immortal-sniper1/Bird_Detector/Bird_detector_V1/Pictures/Audio_Power.png

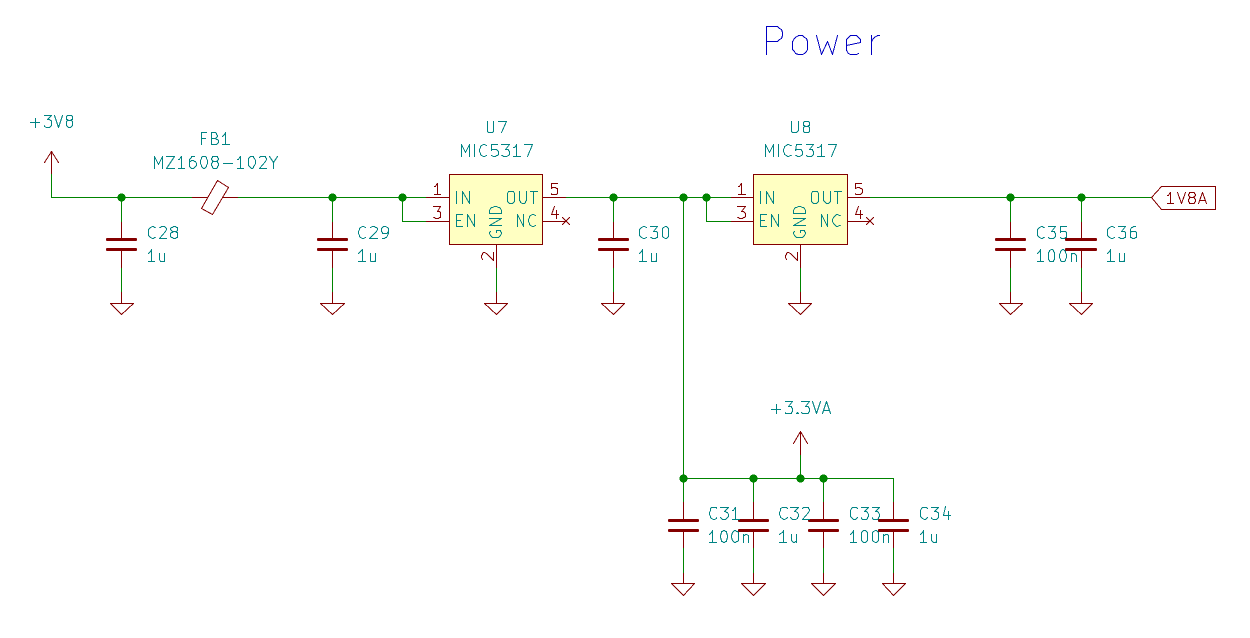
Bird_detector_V1/Pictures/Audio_Power.png
