immortal-sniper1/Bird_Detector/Bird_detector_V1/Pictures/filters_and_gain.png

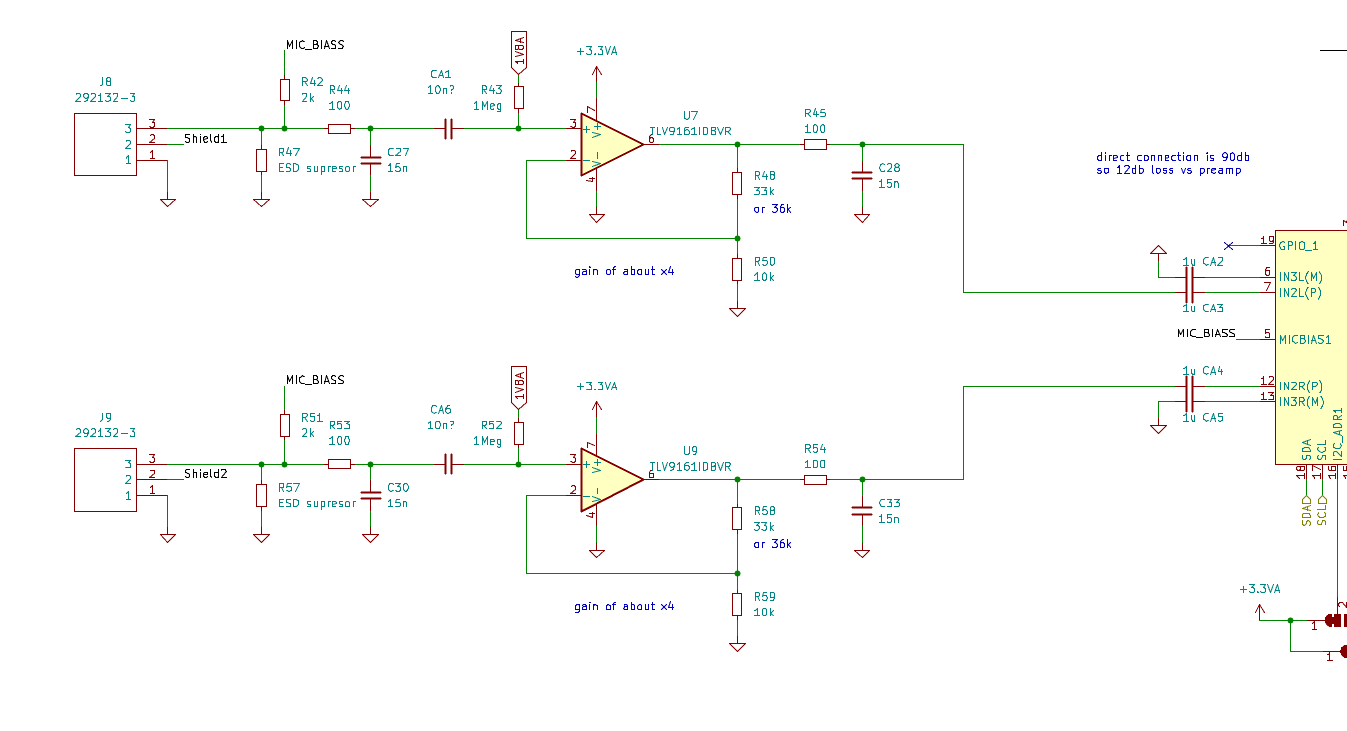
Bird_detector_V1/Pictures/filters_and_gain.png
