immortal-sniper1/Bird_Detector/Box/option2_smaller/EC-912-9.STEP

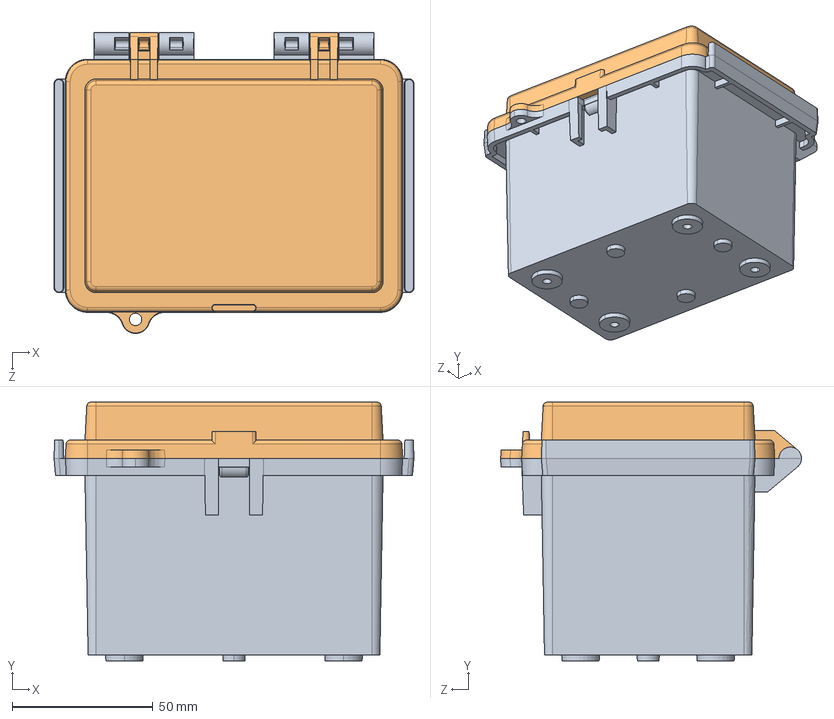
[picture p3: CAD file, 2022-11-06]
Box/option2_smaller/EC-912-9.STEP
128.0 x 92.0 x 107.0 mm
EC-912-P-1-G-9
EC-912-P-2
