immortal-sniper1/Bird_Detector/Box/option1_large/EC-1015-8.STEP

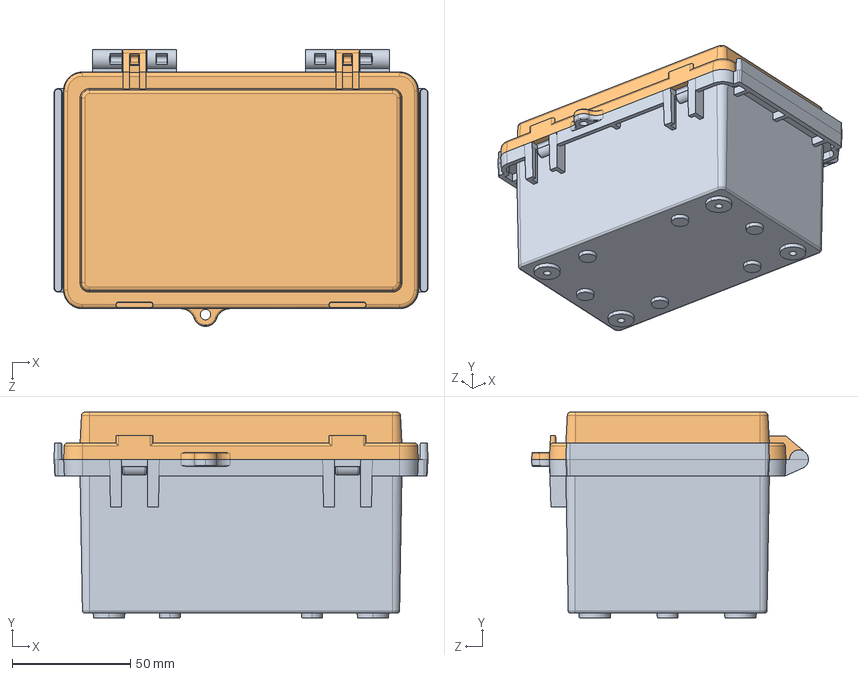
[picture p4: CAD file, 2022-11-06]
Box/option1_large/EC-1015-8.STEP
158.0 x 87.0 x 117.0 mm
EC-1015-P-2
EC-1015-P-1
