immortal-sniper1/Bird_Detector/(list of files, cad)

Other CAD files:
Box/option1_large/EC-1015-P-1-G-65.DXF
Box/option1_large/EC-1015-P-2.DXF
Box/option1_large/EC-1015-8.DXF
Box/option2_smaller/EC-912-9.DXF
