immortal-sniper1/Bird_Detector/Cell_Holder_Board/schematic.pdf

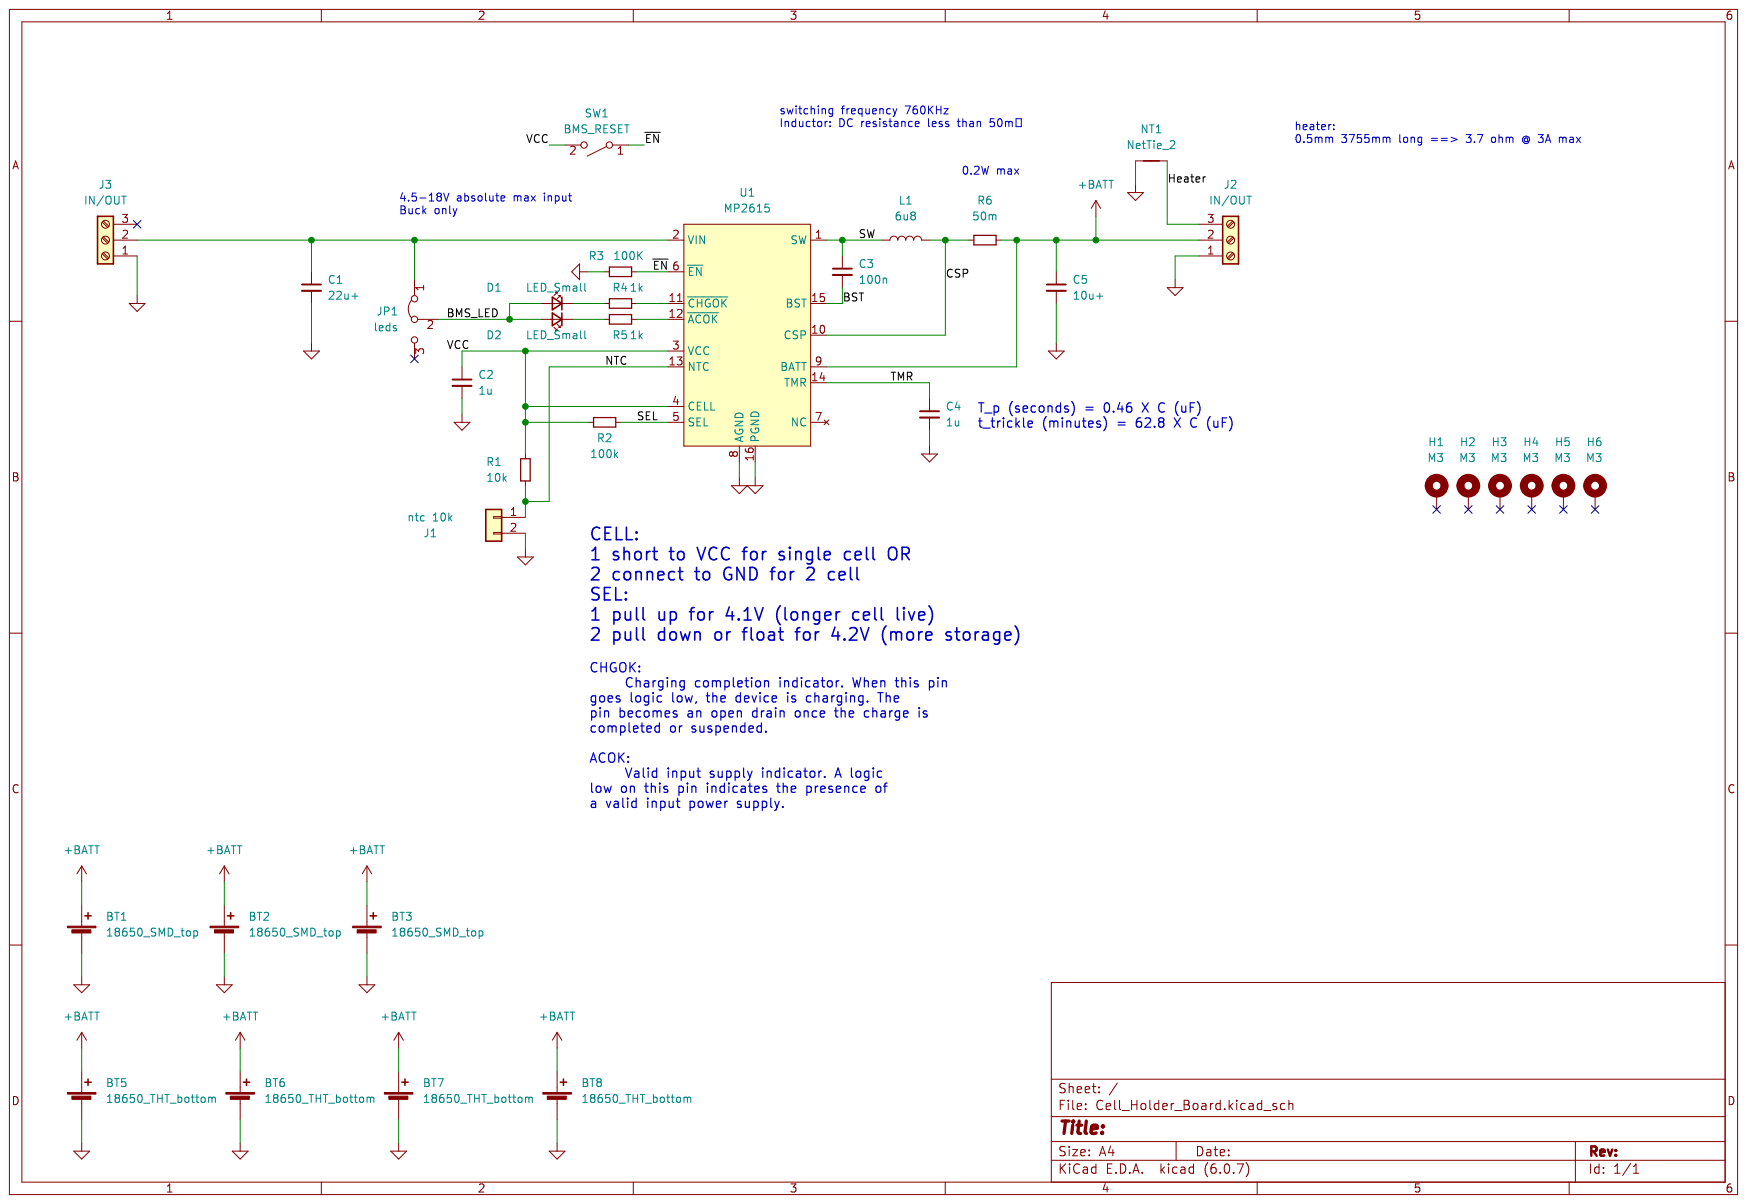
[picture p13: page 1]
