immortal-sniper1/Bird_Detector/Cell_Holder_Board_V2/schematic.pdf

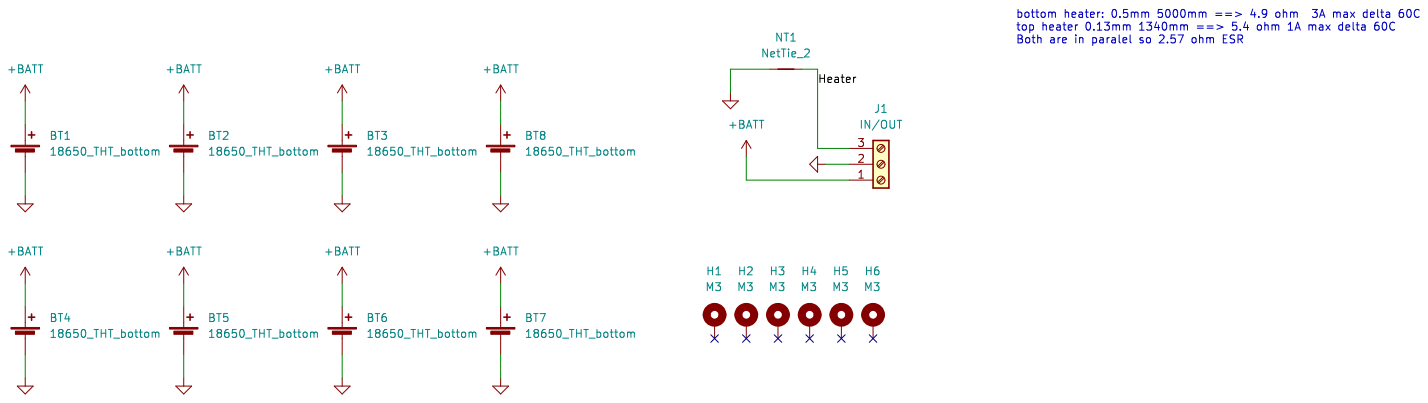
[picture p14: page 1]
