immortal-sniper1/Bird_Detector/LTSpice_simulations/test_pmos.asc

B1: bv; V = if(V(BATT_OUT)< 3,V(BATT_OUT),0)
D1: diode
M1: pmos
M5: pmos
M6: pmos
R1: res; 10
R7: res; 1k
R8: res; 100k
Solar: voltage; PWL(0 6 0.1 15 0.3 15 0.45 0)
V1: voltage; PWL(0 4.2 0.3 4.2 0.5 2.4)
VBus: voltage; 5; Rser=0.01
Named nets: 0, BATT_in, VCC_solar, Vcc_USB, BMS_signal, BATT_OUT
.tran 0.5 startup
.model sw sw vt=1
.model testn nmos(kp=90u vt0=1 lambda=0.01)
.model testn pmos(kp=90u vt0=1 lambda=0.01)
