immortal-sniper1/Bird_Detector/LTSpice_simulations/power_switching_full_MOSFET.asc

B1: bv; V = if(V(BATT_OUT)< 3,V(BATT_OUT),0)
B2: bi; I=2
B3: bi; I=0.75
M5: pmos
M6: pmos
M7: pmos
M8: pmos
M9: nmos
M10: nmos
R7: res; 1k
R8: res; 100k
R10: res; 100k
R11: res; 100k
Solar: voltage; PWL(0 6 0.1 15 0.3 15 0.45 0)
VBus: voltage; 0; Rser=0.01
Named nets: 0, BATT_in, BATT_out, VCC_solar, Vcc_USB, BMS_signal
.tran 0.5 startup
.model sw sw vt=1
.model testn nmos(kp=90u vt0=1 lambda=0.01)
.model testn pmos(kp=90u vt0=1 lambda=0.01)
