immortal-sniper1/Bird_Detector/LTSpice_simulations/power_switching.asc

A1: inv
B1: bv; V = if(V(BATT_OUT)< 3,V(BATT_OUT),0)
B2: bi; I=10/ V(BATT_in)
D1: diode
D2: diode
Li_ion_cells: voltage; PWL(0 4.2 0.3 4.2 0.5 2.4); Rser=0.075
M1: pmos
M2: pmos
M3: pmos
M4: pmos
R1: res; 1k
R2: res; 100k
R4: res; 100k
R5: res; 100k
R6: res; 10
S1: sw
S2: sw
Solar: voltage; PWL(0 6 0.1 15 0.3 15 0.45 0)
V1: voltage; 0
VBus: voltage; 0; Rser=0.01
Named nets: 0, BATT_in, BATT_out, VCC_solar, Vcc_USB, BMS_signal
.tran 0.5 startup
.model sw sw vt=1
.model testn nmos(kp=90u vt0=1 lambda=0.01)
.model testn pmos(kp=90u vt0=1 lambda=0.01)
